IoT-systems-2023-2024/vooraan/(commit log)

2023-10-20 aanmaak kicad project
    [pcbIOT.kicad_pcb, pcbIOT.kicad_sch]
2023-11-02 Update schema
    [pcbIOT.kicad_sch]
2023-11-05 Update pcbIOT.kicad_sch
    Vervangen buck converter en aanpassing weerstandswaarde naar correcte value
    [pcbIOT.kicad_sch]
2023-11-09 Update pcbIOT.kicad_sch
    Laatste versie schema + alle footprints ok
    [pcbIOT.kicad_sch]
2023-11-11 pcb bijna af
    [pcbIOT.kicad_sch, pcbIOTcopybeforechange.kicad_pcb]
2023-11-12 Schema update
    [pcbIOT.kicad_pcb, pcbIOT.kicad_sch]
2023-11-24 BLE1
    BLE mogelijk om integer naar gsm te versturen, dit om te testen
    [pcbIOT-B_Cu.gbr, pcbIOT-B_Mask.gbr, pcbIOT-B_Silkscreen.gbr, pcbIOT-Edge_Cuts.gbr, pcbIOT-F_Cu.gbr, pcbIOT-F_Mask.gbr, pcbIOT-F_Silkscreen.gbr, pcbIOT-job.gbrjob]
2023-12-09 vl53
    i2c
